KSIUJ/cluster-powercontroller/README.md

# cluster-powercontroller
AVR-based node power controller for the KSI computer cluster

* 32 opto-isolated channels
* Atmel ATMega328P
* USB interface via FT232R
