KSIUJ/cluster-powercontroller/Hardware/main.brd

## EAGLE design Hardware/main.brd (2017-01-07)

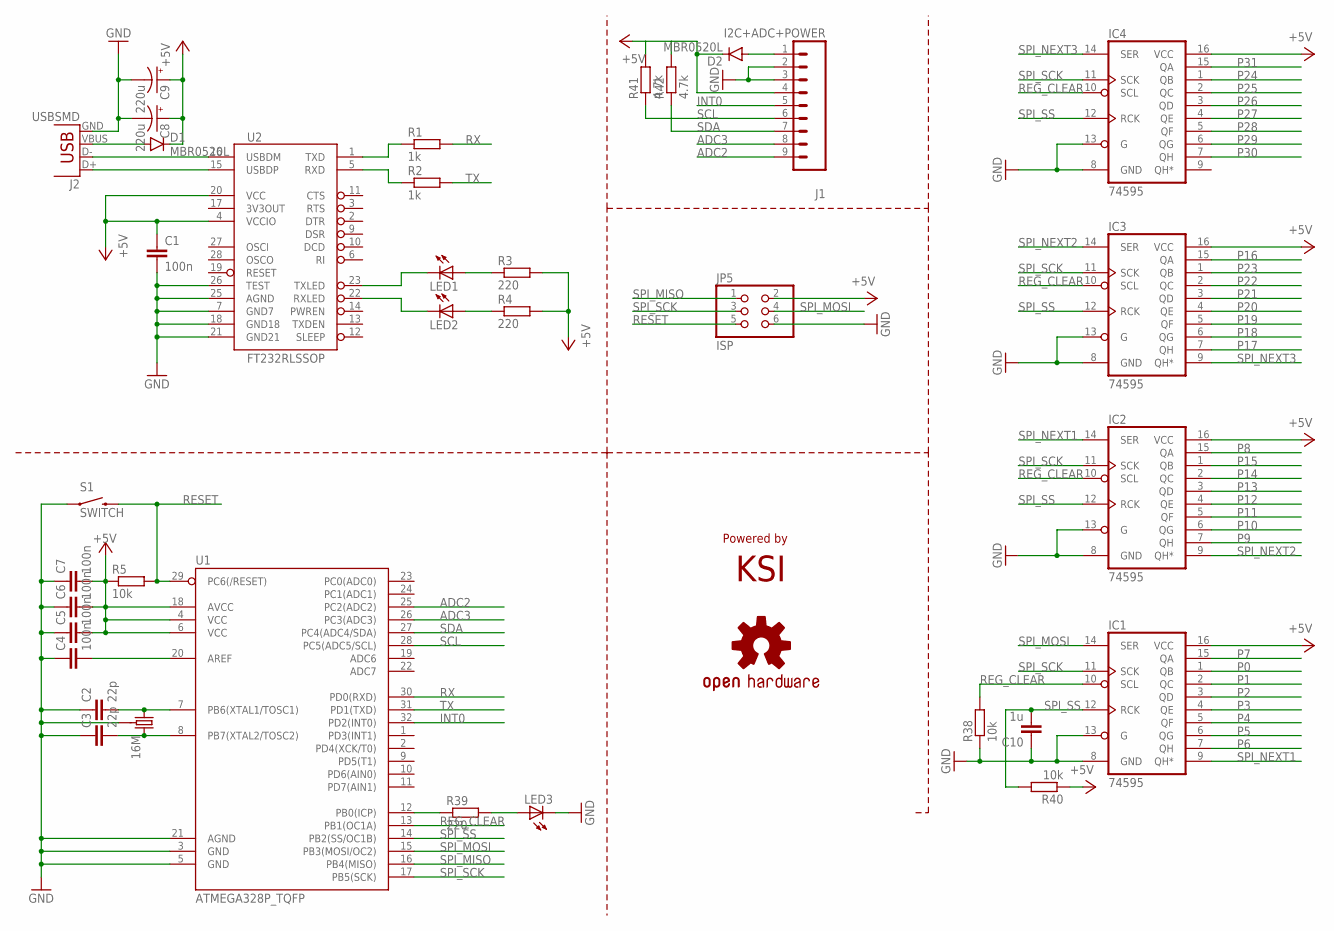
[picture p3: schematic main.sch, sheet 1]

Parts:
C1, C4, C5, C6, C7: 100n; C0805
C2, C3: 22p; C0805
C8, C9: 220u; EIA7343
C10: 1u; C0805
D1, D2: MBR0520L; SOD-123
IC1, IC2, IC3, IC4: 74595; TSSOP16
J1: I2C+ADC+POWER; 1X09
J2: USBSMD; USB-MINIB
JP5: ISP; 2X03
LED1, LED2, LED3: LEDSML0805; SML0805
LOGO1: OSHW-LOGOM; OSHW-LOGO-M
R1, R2: 1k; R0805
R3, R4, R39: 220; R0805
R5, R38, R40: 10k; R0805
R41, R42: 4.7k; R0805
S1: SWITCH; TACTILE_SWITCH_TALL
U1: ATMEGA328P_TQFP; TQFP32-08
U2: FT232RLSSOP; SSOP28DB
U$17: KSI; KSI_LOGO
Y2: 16M; CRYSTAL-SMD-5X3

Connections:
+5V: C1.1, C5.2, C6.2, C7.2, C8.A (+), C9.A (+), D1.C, D2.C, IC1.16 (VCC), IC2.16 (VCC), IC3.16 (VCC), IC4.16 (VCC), J1.4, JP5.2, R3.2, R4.2, R5.1, R40.1, R41.2, R42.2, U1.4 (VCC), U1.6 (VCC), U1.18 (AVCC), U2.4 (VCCIO), U2.20 (VCC); also elsewhere on the board
ADC2: J1.9, U1.25 (PC2(ADC2))
ADC3: J1.8, U1.26 (PC3(ADC3))
GND: C1.2, C2.1, C3.1, C4.1, C5.1, C6.1, C7.1, C8.C (-), C9.C (-), C10.1, IC1.8 (GND), IC1.13 (G), IC2.8 (GND), IC2.13 (G), IC3.8 (GND), IC3.13 (G), IC4.8 (GND), IC4.13 (G), J1.2, J1.3, J2.GND, JP5.6, LED3.C, R38.1, S1.A2 (1), U1.3 (GND), U1.5 (GND), U1.21 (AGND), U2.7 (GND7), U2.18 (GND18), U2.21 (GND21), U2.25 (AGND), U2.26 (TEST), Y2.2 (3), Y2.4 (3)
INT0: J1.5, U1.32 (PD2(INT0))
unnamed: J2.D-, U2.16 (USBDM)
unnamed: J2.D+, U2.15 (USBDP)
unnamed: R1.1, U2.1 (TXD)
unnamed: R2.1, U2.5 (RXD)
unnamed: LED1.A, R3.1
unnamed: LED2.A, R4.1
unnamed: LED1.C, U2.23 (TXLED)
unnamed: LED2.C, U2.22 (RXLED)
unnamed: C2.2, U1.7 (PB6(XTAL1/TOSC1)), Y2.3 (1)
unnamed: C3.2, U1.8 (PB7(XTAL2/TOSC2)), Y2.1 (2)
unnamed: C4.2, U1.20 (AREF)
unnamed: R39.1, U1.12 (PB0(ICP))
unnamed: LED3.A, R39.2
unnamed: D1.A, J2.VBUS
unnamed: D2.A, J1.1
P0: IC1.1 (QB); also elsewhere on the board
P1: IC1.2 (QC); also elsewhere on the board
P2: IC1.3 (QD); also elsewhere on the board
P3: IC1.4 (QE); also elsewhere on the board
P4: IC1.5 (QF); also elsewhere on the board
P5: IC1.6 (QG); also elsewhere on the board
P6: IC1.7 (QH); also elsewhere on the board
P7: IC1.15 (QA); also elsewhere on the board
P8: IC2.15 (QA); also elsewhere on the board
P9: IC2.7 (QH); also elsewhere on the board
P10: IC2.6 (QG); also elsewhere on the board
P11: IC2.5 (QF); also elsewhere on the board
P12: IC2.4 (QE); also elsewhere on the board
P13: IC2.3 (QD); also elsewhere on the board
P14: IC2.2 (QC); also elsewhere on the board
P15: IC2.1 (QB); also elsewhere on the board
P16: IC3.15 (QA); also elsewhere on the board
P17: IC3.7 (QH); also elsewhere on the board
P18: IC3.6 (QG); also elsewhere on the board
P19: IC3.5 (QF); also elsewhere on the board
P20: IC3.4 (QE); also elsewhere on the board
P21: IC3.3 (QD); also elsewhere on the board
P22: IC3.2 (QC); also elsewhere on the board
P23: IC3.1 (QB); also elsewhere on the board
P24: IC4.1 (QB); also elsewhere on the board
P25: IC4.2 (QC); also elsewhere on the board
P26: IC4.3 (QD); also elsewhere on the board
P27: IC4.4 (QE); also elsewhere on the board
P28: IC4.5 (QF); also elsewhere on the board
P29: IC4.6 (QG); also elsewhere on the board
P30: IC4.7 (QH); also elsewhere on the board
P31: IC4.15 (QA); also elsewhere on the board
REG_CLEAR: IC1.10 (SCL), IC2.10 (SCL), IC3.10 (SCL), IC4.10 (SCL), R38.2, U1.13 (PB1(OC1A))
RESET: JP5.5, R5.2, S1.B2 (2), U1.29 (PC6(/RESET))
RX: R1.2, U1.30 (PD0(RXD))
SCL: J1.6, R41.1, U1.28 (PC5(ADC5/SCL))
SDA: J1.7, R42.1, U1.27 (PC4(ADC4/SDA))
SPI_MISO: JP5.1, U1.16 (PB4(MISO))
SPI_MOSI: IC1.14 (SER), JP5.4, U1.15 (PB3(MOSI/OC2))
SPI_NEXT1: IC1.9 (QH*), IC2.14 (SER)
SPI_NEXT2: IC2.9 (QH*), IC3.14 (SER)
SPI_NEXT3: IC3.9 (QH*), IC4.14 (SER)
SPI_SCK: IC1.11 (SCK), IC2.11 (SCK), IC3.11 (SCK), IC4.11 (SCK), JP5.3, U1.17 (PB5(SCK))
SPI_SS: C10.2, IC1.12 (RCK), IC2.12 (RCK), IC3.12 (RCK), IC4.12 (RCK), R40.2, U1.14 (PB2(SS/OC1B))
TX: R2.2, U1.31 (PD1(TXD))

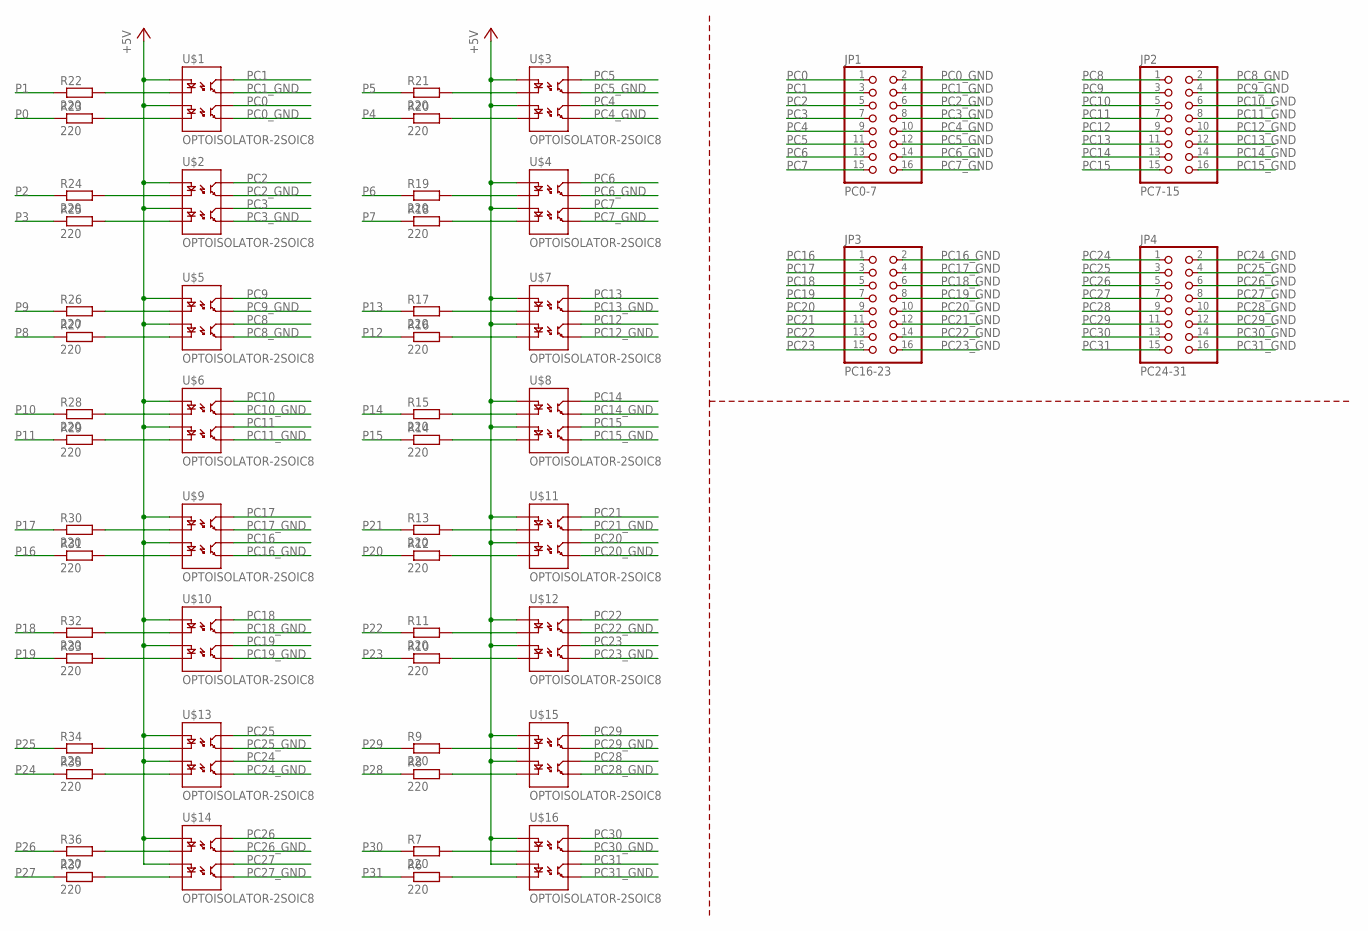
[picture p4: schematic main.sch, sheet 2]

Parts:
JP1: PC0-7; 2X08
JP2: PC7-15; 2X08
JP3: PC16-23; 2X08
JP4: PC24-31; 2X08
R6, R7, R8, R9, R10, R11, R12, R13, R14, R15, R16, R17, R18, R19, R20, R21, R22, R23, R24, R25, R26, R27, R28, R29, R30, R31, R32, R33, R34, R35, R36, R37: 220; R0805
U$1, U$2, U$3, U$4, U$5, U$6, U$7, U$8, U$9, U$10, U$11, U$12, U$13, U$14, U$15, U$16: OPTOISOLATOR-2SOIC8; SO08-2

Connections:
+5V: U$1.1 (A1), U$1.3 (A2), U$2.1 (A1), U$2.3 (A2), U$3.1 (A1), U$3.3 (A2), U$4.1 (A1), U$4.3 (A2), U$5.1 (A1), U$5.3 (A2), U$6.1 (A1), U$6.3 (A2), U$7.1 (A1), U$7.3 (A2), U$8.1 (A1), U$8.3 (A2), U$9.1 (A1), U$9.3 (A2), U$10.1 (A1), U$10.3 (A2), U$11.1 (A1), U$11.3 (A2), U$12.1 (A1), U$12.3 (A2), U$13.1 (A1), U$13.3 (A2), U$14.1 (A1), U$14.3 (A2), U$15.1 (A1), U$15.3 (A2), U$16.1 (A1), U$16.3 (A2); also elsewhere on the board
unnamed: R37.2, U$14.4 (C2)
unnamed: R36.2, U$14.2 (C1)
unnamed: R35.2, U$13.4 (C2)
unnamed: R34.2, U$13.2 (C1)
unnamed: R33.2, U$10.4 (C2)
unnamed: R32.2, U$10.2 (C1)
unnamed: R31.2, U$9.4 (C2)
unnamed: R30.2, U$9.2 (C1)
unnamed: R27.2, U$5.4 (C2)
unnamed: R26.2, U$5.2 (C1)
unnamed: R25.2, U$2.4 (C2)
unnamed: R24.2, U$2.2 (C1)
unnamed: R23.2, U$1.4 (C2)
unnamed: R22.2, U$1.2 (C1)
unnamed: R21.2, U$3.2 (C1)
unnamed: R20.2, U$3.4 (C2)
unnamed: R19.2, U$4.2 (C1)
unnamed: R18.2, U$4.4 (C2)
unnamed: R17.2, U$7.2 (C1)
unnamed: R16.2, U$7.4 (C2)
unnamed: R15.2, U$8.2 (C1)
unnamed: R14.2, U$8.4 (C2)
unnamed: R13.2, U$11.2 (C1)
unnamed: R12.2, U$11.4 (C2)
unnamed: R11.2, U$12.2 (C1)
unnamed: R10.2, U$12.4 (C2)
unnamed: R9.2, U$15.2 (C1)
unnamed: R8.2, U$15.4 (C2)
unnamed: R7.2, U$16.2 (C1)
unnamed: R6.2, U$16.4 (C2)
unnamed: R28.2, U$6.2 (C1)
unnamed: R29.2, U$6.4 (C2)
P0: R23.1; also elsewhere on the board
P1: R22.1; also elsewhere on the board
P2: R24.1; also elsewhere on the board
P3: R25.1; also elsewhere on the board
P4: R20.1; also elsewhere on the board
P5: R21.1; also elsewhere on the board
P6: R19.1; also elsewhere on the board
P7: R18.1; also elsewhere on the board
P8: R27.1; also elsewhere on the board
P9: R26.1; also elsewhere on the board
P10: R28.1; also elsewhere on the board
P11: R29.1; also elsewhere on the board
P12: R16.1; also elsewhere on the board
P13: R17.1; also elsewhere on the board
P14: R15.1; also elsewhere on the board
P15: R14.1; also elsewhere on the board
P16: R31.1; also elsewhere on the board
P17: R30.1; also elsewhere on the board
P18: R32.1; also elsewhere on the board
P19: R33.1; also elsewhere on the board
P20: R12.1; also elsewhere on the board
P21: R13.1; also elsewhere on the board
P22: R11.1; also elsewhere on the board
P23: R10.1; also elsewhere on the board
P24: R35.1; also elsewhere on the board
P25: R34.1; also elsewhere on the board
P26: R36.1; also elsewhere on the board
P27: R37.1; also elsewhere on the board
P28: R8.1; also elsewhere on the board
P29: R9.1; also elsewhere on the board
P30: R7.1; also elsewhere on the board
P31: R6.1; also elsewhere on the board
PC0: JP1.1, U$1.6 (CL2)
PC0_GND: JP1.2, U$1.5 (EM2)
PC1: JP1.3, U$1.8 (CL1)
PC1_GND: JP1.4, U$1.7 (EM1)
PC2: JP1.5, U$2.8 (CL1)
PC2_GND: JP1.6, U$2.7 (EM1)
PC3: JP1.7, U$2.6 (CL2)
PC3_GND: JP1.8, U$2.5 (EM2)
PC4: JP1.9, U$3.6 (CL2)
PC4_GND: JP1.10, U$3.5 (EM2)
PC5: JP1.11, U$3.8 (CL1)
PC5_GND: JP1.12, U$3.7 (EM1)
PC6: JP1.13, U$4.8 (CL1)
PC6_GND: JP1.14, U$4.7 (EM1)
PC7: JP1.15, U$4.6 (CL2)
PC7_GND: JP1.16, U$4.5 (EM2)
PC8: JP2.1, U$5.6 (CL2)
PC8_GND: JP2.2, U$5.5 (EM2)
PC9: JP2.3, U$5.8 (CL1)
PC9_GND: JP2.4, U$5.7 (EM1)
PC10: JP2.5, U$6.8 (CL1)
PC10_GND: JP2.6, U$6.7 (EM1)
PC11: JP2.7, U$6.6 (CL2)
PC11_GND: JP2.8, U$6.5 (EM2)
PC12: JP2.9, U$7.6 (CL2)
PC12_GND: JP2.10, U$7.5 (EM2)
PC13: JP2.11, U$7.8 (CL1)
PC13_GND: JP2.12, U$7.7 (EM1)
PC14: JP2.13, U$8.8 (CL1)
PC14_GND: JP2.14, U$8.7 (EM1)
PC15: JP2.15, U$8.6 (CL2)
PC15_GND: JP2.16, U$8.5 (EM2)
PC16: JP3.1, U$9.6 (CL2)
PC16_GND: JP3.2, U$9.5 (EM2)
PC17: JP3.3, U$9.8 (CL1)
PC17_GND: JP3.4, U$9.7 (EM1)
PC18: JP3.5, U$10.8 (CL1)
PC18_GND: JP3.6, U$10.7 (EM1)
PC19: JP3.7, U$10.6 (CL2)
PC19_GND: JP3.8, U$10.5 (EM2)
PC20: JP3.9, U$11.6 (CL2)
PC20_GND: JP3.10, U$11.5 (EM2)
PC21: JP3.11, U$11.8 (CL1)
PC21_GND: JP3.12, U$11.7 (EM1)
PC22: JP3.13, U$12.8 (CL1)
PC22_GND: JP3.14, U$12.7 (EM1)
PC23: JP3.15, U$12.6 (CL2)
PC23_GND: JP3.16, U$12.5 (EM2)
PC24: JP4.1, U$13.6 (CL2)
PC24_GND: JP4.2, U$13.5 (EM2)
PC25: JP4.3, U$13.8 (CL1)
PC25_GND: JP4.4, U$13.7 (EM1)
PC26: JP4.5, U$14.8 (CL1)
PC26_GND: JP4.6, U$14.7 (EM1)
PC27: JP4.7, U$14.6 (CL2)
PC27_GND: JP4.8, U$14.5 (EM2)
PC28: JP4.9, U$15.6 (CL2)
PC28_GND: JP4.10, U$15.5 (EM2)
PC29: JP4.11, U$15.8 (CL1)
PC29_GND: JP4.12, U$15.7 (EM1)
PC30: JP4.13, U$16.8 (CL1)
PC30_GND: JP4.14, U$16.7 (EM1)
PC31: JP4.15, U$16.6 (CL2)
PC31_GND: JP4.16, U$16.5 (EM2)

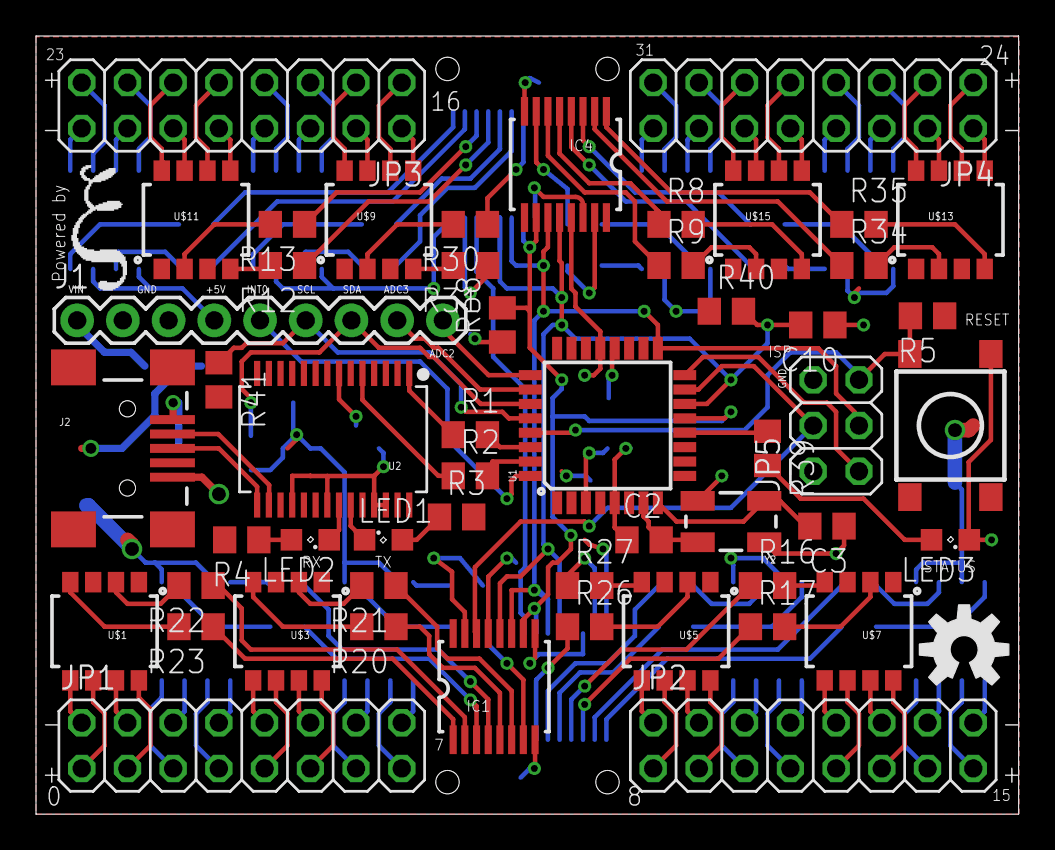
[picture p5: board main.brd from above]

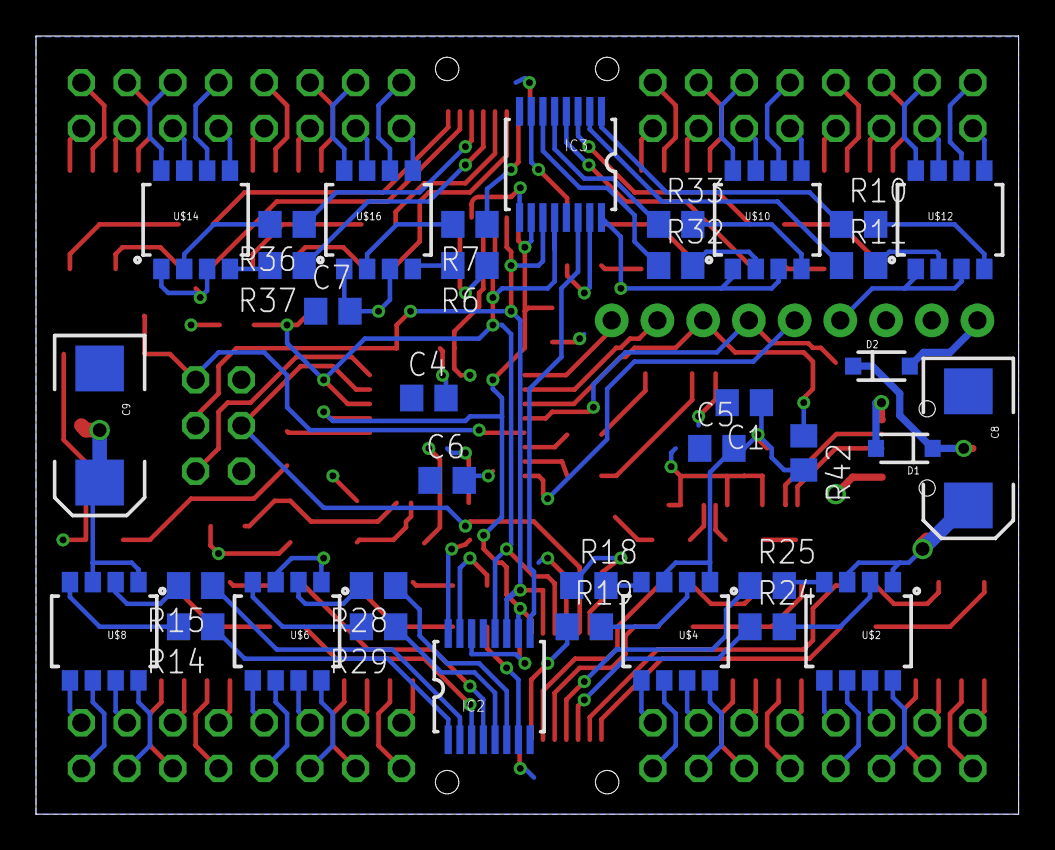
[picture p6: board main.brd from below]

Board: 2 copper layers, 54.6 x 43.2 mm, 90 parts (36 on the bottom side), 161 nets.
