KSIUJ/cluster-powercontroller/Firmware/Firmware/shift_regs.h

/*
 * shift_regs.h
 *
 * Created: 2017-03-25 23:20:46
 *  Author: Adam
 */ 


#ifndef SHIFT_REGS_H_
#define SHIFT_REGS_H_

#include <stdint.h>

void initRegs();
void setRegs(uint32_t data);

#endif /* SHIFT_REGS_H_ */
