KSIUJ/cluster-powercontroller/(commit log)

2017-01-04 Add hardware design files
    [main.brd, main.sch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]
2017-01-07 Add pin descriptions on pcb, optimize +5V polygon
    [main.brd]
2017-03-27 Add Controller class and power on/off commands
2017-03-27 Fix error code 15 convention mismatch
    [proto.cpp]
2017-05-17 Change checksum to XOR, fix bug in controller
    [Interpreter.cpp, controller.cpp, proto.cpp]
2017-05-17 Fix reset source detection
    [main.cpp]
